AdzCoder/rocket-sensors/docs/Micro.png

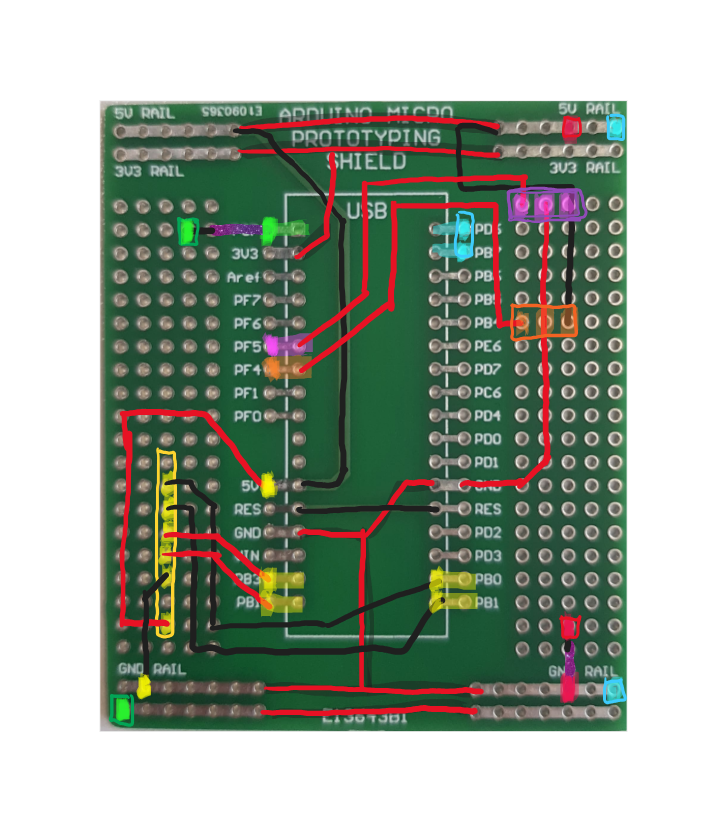
docs/Micro.png
