AdzCoder/rocket-sensors/data/heat_test_data.csv

Time | Pressure | TempC | Height | AccX | AccY | AccZ | AccT | wX | wY | wZ0
7929 | 100507.82 | 23.93 | 0.06 | -0.37 | -0.92 | 9.97 | 10.02 | 0.00 | 0.00 | 0.00
8160 | 100507.82 | 32.71 | 0.06 | -0.36 | -0.91 | 9.92 | 9.97 | 0.00 | 0.00 | 0.00
8433 | 100616.32 | 25.39 | 0.00 | -0.36 | -0.92 | 9.95 | 10.00 | 0.00 | 0.00 | 0.00
8664 | 100616.32 | 28.81 | 0.00 | -0.37 | -0.92 | 9.97 | 10.02 | 0.00 | 0.00 | 0.00
8936 | 100507.82 | 23.93 | 0.06 | -0.37 | -0.92 | 9.98 | 10.03 | 0.00 | 0.00 | 0.00
9189 | 100507.82 | 36.13 | 0.06 | -0.36 | -0.92 | 9.97 | 10.02 | 0.00 | 0.00 | 0.00
9443 | 100616.32 | 42.48 | 0.00 | -0.36 | -0.92 | 9.96 | 10.01 | 0.00 | 0.00 | 0.00
9740 | 100616.32 | 23.93 | 0.00 | -0.35 | -0.92 | 9.96 | 10.01 | 0.00 | 0.00 | 0.00
10012 | 100616.32 | 47.85 | 0.00 | -0.37 | -0.92 | 10.01 | 10.06 | 0.00 | 0.00 | 0.00
10340 | 100616.32 | 23.93 | 0.00 | -0.37 | -0.92 | 9.93 | 9.98 | 0.00 | 0.00 | 0.00
10612 | 100616.32 | 24.41 | 0.00 | -0.37 | -0.92 | 9.97 | 10.02 | 0.00 | 0.00 | 0.00
10939 | 100616.32 | 24.41 | 0.00 | -0.37 | -0.92 | 9.96 | 10.01 | 0.00 | 0.00 | 0.00
11211 | 100616.32 | 23.93 | 0.00 | -0.36 | -0.92 | 9.98 | 10.03 | 0.00 | 0.00 | 0.00
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
