AdzCoder/rocket-sensors/data/lift_test_data.csv

Time | Pressure | TempC | Height | AccX | AccY | AccZ | AccT | wX | wY | wZ
466 | 100616.32 | 42.48 | 0.00 | -0.32 | -0.68 | 10.04 | 10.07 | -0.37 | 0.92 | 58.41
739 | 100616.32 | 26.86 | 0.00 | -0.31 | -0.67 | 10.06 | 10.09 | -0.06 | -0.73 | 0.73
970 | 100616.32 | 36.62 | 0.00 | -0.32 | -0.67 | 10.02 | 10.05 | -0.12 | -0.73 | 0.73
1243 | 100616.32 | 20.51 | 0.00 | -0.33 | -0.67 | 10.02 | 10.05 | -0.12 | -0.73 | 0.79
2022 | 100616.32 | 39.06 | 0.00 | -0.29 | -0.65 | 10.00 | 10.03 | -0.12 | -0.73 | 0.79
2459 | 100616.32 | 35.64 | 0.00 | -0.30 | -0.70 | 10.00 | 10.03 | -0.18 | -0.73 | 0.85
2733 | 100616.32 | 28.81 | 0.00 | -0.33 | -0.68 | 10.01 | 10.03 | -0.18 | -0.73 | 0.85
3050 | 100616.32 | 43.95 | 0.00 | -0.30 | -0.69 | 9.99 | 10.02 | -0.06 | -0.73 | 0.73
3322 | 100616.32 | 43.95 | 0.00 | -0.31 | -0.69 | 9.99 | 10.02 | -0.12 | -0.73 | 0.73
3647 | 100616.32 | 17.58 | 0.00 | -0.29 | -0.67 | 9.99 | 10.02 | -0.12 | -0.73 | 0.79
3919 | 100724.83 | 17.09 | -0.06 | -0.26 | -0.69 | 10.00 | 10.03 | 0.00 | 0.00 | 0.00
4246 | 100724.83 | 31.74 | -0.06 | -0.30 | -0.69 | 9.99 | 10.02 | 0.00 | 0.00 | 0.00
4519 | 100616.32 | 43.46 | 0.00 | -0.29 | -0.70 | 10.23 | 10.25 | 0.00 | 0.00 | 0.00
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
