AdzCoder/rocket-sensors/data/pressure_test_data.csv

Time | Pressure | TempC | Height | AccX | AccY | AccZ | AccT | wX | wY | wZ
35677 | 100507.82 | 27.83 | 0 | -0.04 | -0.51 | 9.99 | 10 | 0 | 0 | 0
36395 | 100616.32 | 28.32 | -0.06 | -0.06 | -0.51 | 10 | 10.01 | 0 | 0 | 0
36671 | 100616.32 | 45.9 | -0.06 | -0.06 | -0.51 | 10 | 10.01 | 0 | 0 | 0
36902 | 100507.82 | 19.53 | 0 | -0.06 | -0.51 | 10 | 10.01 | 0 | 0 | 0
37175 | 100616.32 | 29.3 | -0.06 | -0.05 | -0.51 | 9.99 | 10 | 0 | 0 | 0
37406 | 100507.82 | 30.76 | 0 | -0.06 | -0.51 | 10 | 10.01 | 0 | 0 | 0
37679 | 100616.32 | 40.04 | -0.06 | -0.06 | -0.5 | 10 | 10.01 | 0 | 0 | 0
37910 | 100616.32 | 21 | -0.06 | -0.06 | -0.51 | 10 | 10.01 | 0 | 0 | 0
38185 | 100507.82 | 21.48 | 0 | -0.06 | -0.51 | 10 | 10.01 | 0 | 0 | 0
38449 | 100616.32 | 46.39 | -0.06 | -0.05 | -0.51 | 10 | 10.01 | 0 | 0 | 0
38689 | 100616.32 | 41.99 | -0.06 | -0.06 | -0.51 | 10.01 | 10.02 | 0 | 0 | 0
38988 | 100616.32 | 18.55 | -0.06 | -0.06 | -0.51 | 9.99 | 10 | 0 | 0 | 0
39261 | 100616.32 | 19.04 | -0.06 | -0.06 | -0.51 | 10 | 10.01 | 0 | 0 | 0
39587 | 100616.32 | 19.04 | -0.06 | -0.06 | -0.51 | 10 | 10.01 | 0 | 0 | 0
39860 | 100616.32 | 25.39 | -0.06 | -0.05 | -0.51 | 10 | 10.01 | 0 | 0 | 0
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
