AdzCoder/rocket-sensors/(commit log)

2025-12-05 Initial commit: migrated Arduino code to PlatformIO
    [acceleration_test_data.csv, heat_test_data.csv, lift_test_data.csv, pressure_test_data.csv]
2025-12-07 Refactor and modularize code: separate configuration, data logging, and sensor handling into distinct header and source files; update documentation and improve readability.
2025-12-07 Update documentation and improve sensor error handling; enhance data logging and validation mechanisms
    [config.h, data_logger.cpp, data_logger.h, sensors.cpp, sensors.h]
2025-12-07 Update design and testing documentation; add sensor details and improve clarity
